projectuplift/uplift-tower/uplift-tower-circuit-diagram.png

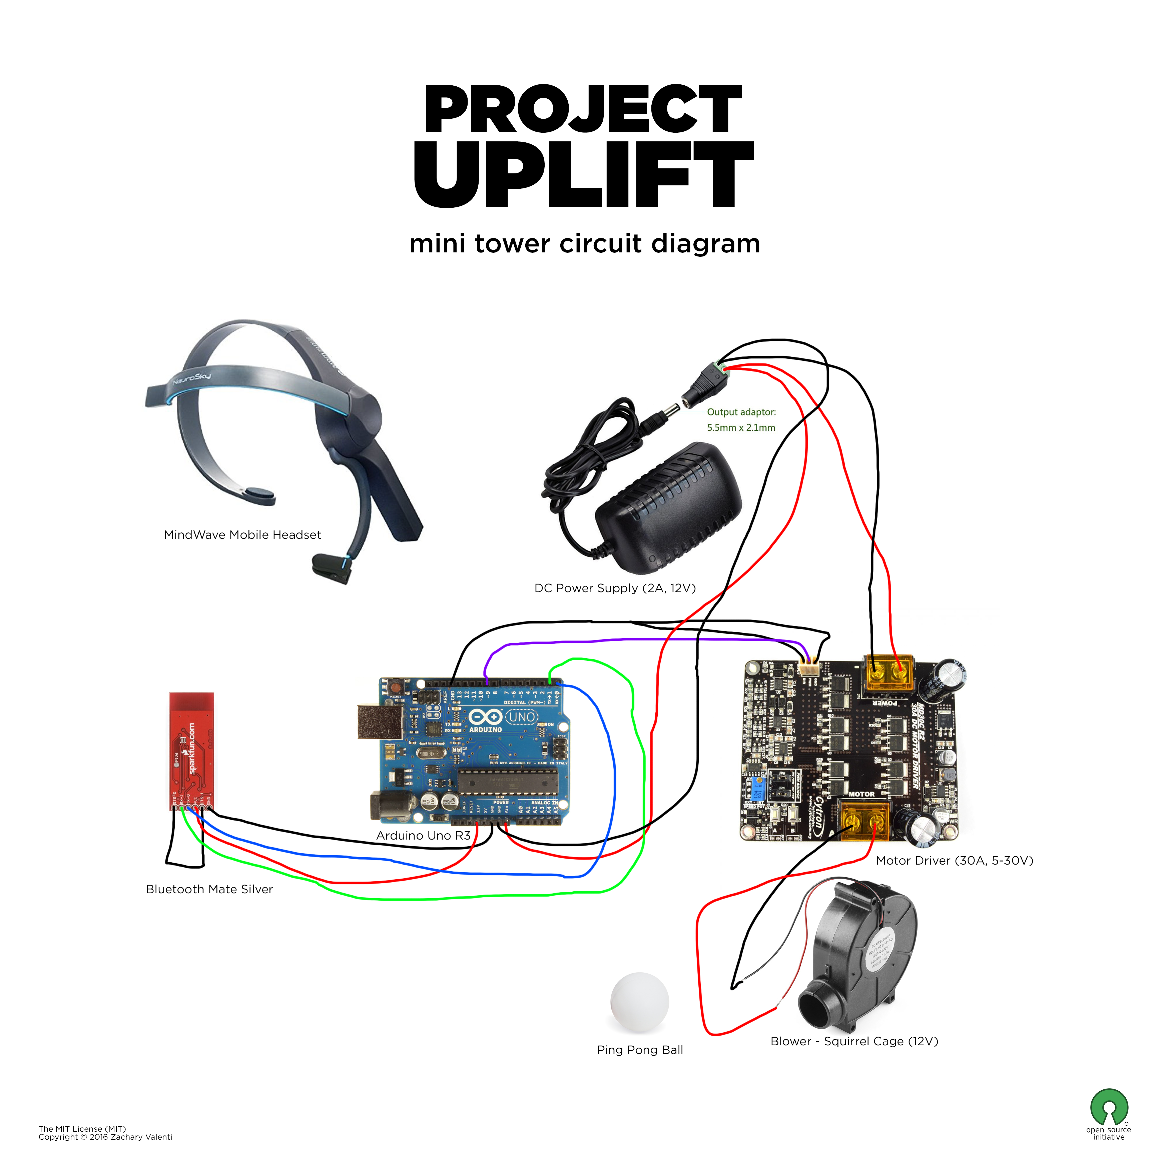
uplift-tower-circuit-diagram.png
