projectuplift/uplift-tower/(commit log)

2016-04-07 initial commit
    This is the first commit of Uplift’s Open Source initiative. More to
    come.
2016-04-07 About page commit
    V1 About the project + contributors + special thanks! Sorry to anyone I
    forgot…. If you notice yourself missing, please do remind me and accept
    my sincere apologizes!
2016-04-07 About to .md
    Because it’s prettier that way…
2016-04-07 Adding circuit diagram
    Added first pass at circuit diagram. There is a non-zero chance that
    the wires from the fan to the motor driver terminals need to be
    flipped. Otherwise, this should be correct.
